sergioibarra98/Hot-Plate/HotPlate_TOP.png

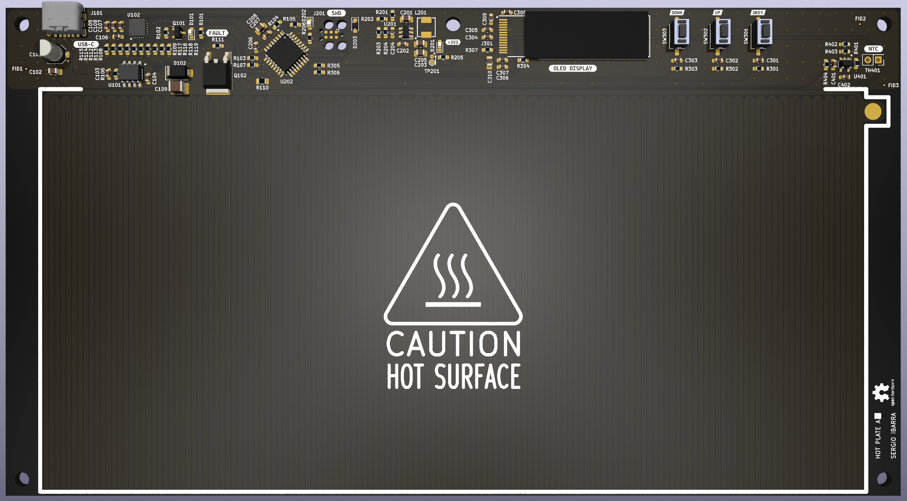
HotPlate_TOP.png
