sergioibarra98/Hot-Plate/01 - KiCad/report.txt

Plotted to 'C:\Users\sergi\Desktop\Hot-Plate\01 - Board\KiCad\HotPlate.pdf'.

Info: Done.
