sergioibarra98/Hot-Plate/03 - Studies/AP62200_AP62300_AP62400_Power-Calculation_Design.xlsx

Sheet: Power Loss
 |  |  |  |  |  |  |  |  |  | Note: In order for the design file to work
Version 2.1 |  |  |  |  |  |  |  |  |  |  | in local region.
 |  |  |  |  |  |  |  |  |  | 1. Go to File, then Option.
Power Loss Calculation |  |  |  |  |  |  |  |  |  | 2. Select Advance.
Part Munber | AP62300T |  |  |  |  |  |  |  |  | 3. Unselect Use System separator
Switching Frequency | 750 | kHz |  | On Time | 377.5225261 | ns
Input Voltage (4.2V-18V) | 12.0 | V |  | Duty Cycle | 0.28
Output Voltage (0.765V-7V) | 3.3 | V |  | Effective Output Resistance | 11.0 | Ohm
Output Current | 0.3 | A |  |  |  |  |  |  |  | 4. Change to local Decimal/Thousand separator to "." or ","
 |  |  |  | Iupper,rms | 0.17 | A |  |  |  | 5. Click OK.
OUTPUT INDUCTOR |  |  |  | Ilower,rms | 0.27 | A
Inductor Current Ripple Ratio (∆I/ILOAD) | 8 | %
Recommended Inductor | 10.3 | uH |  | Current Ripple | 0.32 | Ap-p
Output Inductor (Isat > 5A) | 10.0 | uH |  | Output Voltage Ripple | 12.22833333 | mVp-p |  | Conduction Loss | Switching Loss
DCR | 282 | mOhm |  |  |  |  | Upper MOSFET | 0.002 | 0.045
 |  |  |  |  |  |  | Lower MOSFET | 0.003 | 0.067
OUTPUT CAPACITOR |  |  |  |  |  |  | Driver |  | 0.002
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
