sergioibarra98/Hot-Plate/03 - Studies/01 - Power/Power Consumption.xlsx

Sheet: OVERVIEW
 |  | Corriente (A) | Potencia (W) |  | +15V | +3V3
+15V |  | 3.080 | 36.957 | Heater | Heater
 | +3V3 | 0.232 | 0.766 | PD | PD
 |  |  |  | MCU |  | MCU
 |  |  |  | OLED Screen |  | OLED Screen
 |  |  |  | Thermocoupler |  | Thermocoupler

Sheet: +15V
Descripción | Ref.Power | Consumo Max (mA) | Unidades | Consumo Total(A)
+3V3 |  |  |  | 0.080
Heater | - | 3000 | 1 | 3.000
PD | - | 85 | 1 | 0.085
 |  |  | TOTAL | 3.080

Sheet: +3V3
Descripción | Ref.Power | Consumo Max (mA) | Unidades | Consumo Total(A)
MCU |  | 200 | 1 | 0.200
OLED Screen | - | 30 | 1 | 0.030 |  | * No aparece en datahsset, estimado de otra pantalla de similar tamaño y mismo fab
Thermocoupler | - | 2 | 1 | 0.002
 |  |  | TOTAL | 0.232 | 0.7656 | w
 |  |  | TOTAL (+12V) | 0.080 | 0.957 | w
 |  |  |  |  | 0.1914 | W Ploss
MCU
IVDD |  | 120 | 1 | 120
I_IO |  | 80 | 1 | 80
 |  |  | total | 200

Sheet: MOSFET
 |  |  | NCE3080KA (https://www.lcsc.com/product-detail/MOSFETs_Wuxi-NCE-Power-Semiconductor-NCE3080KA_C152149.html)
I(RMS) | 3
R_DS(on) | 0.035
 |  | Pcon | 0.315
Vin | 12
fsw | 25000
Q_gs | 1.4e-08
Q_gd | 1.1e-08
I_g | 0.1
 |  | Ploss | 0.225
 |  | Ptot= | 0.54
