sergioibarra98/Hot-Plate/01 - KiCad/3D/CUI_DEVICES_TS04-66-50-BK-100-SMT.step

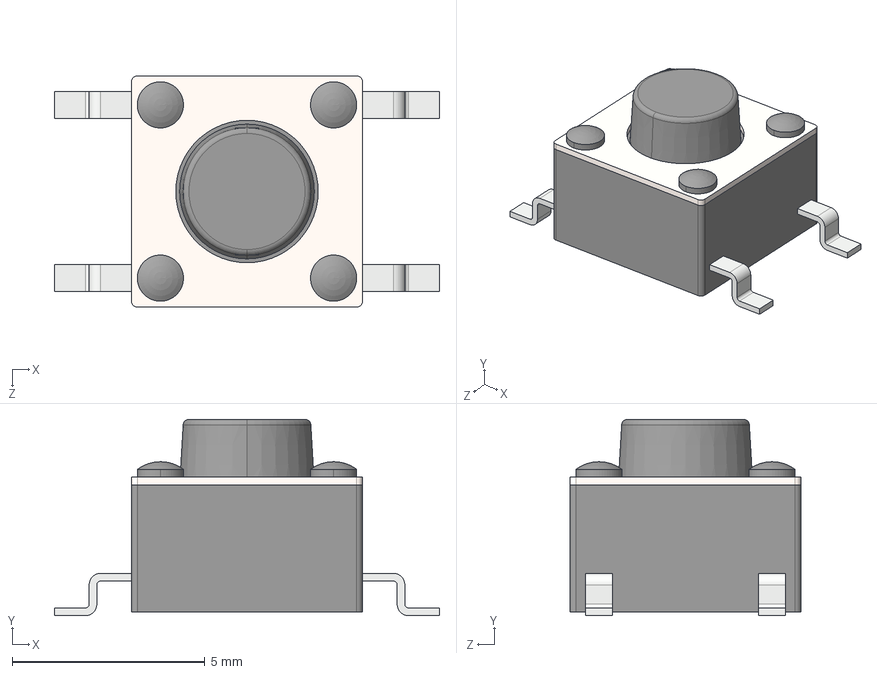
[picture p2: CAD file, 2023-08-11]
01 - KiCad/3D/CUI_DEVICES_TS04-66-50-BK-100-SMT.step
10.0 x 5.10 x 6.00 mm
