sergioibarra98/Hot-Plate/01 - KiCad/3D/SW_Push_1P1T_NO_3.5x8mm_H3mm.STEP

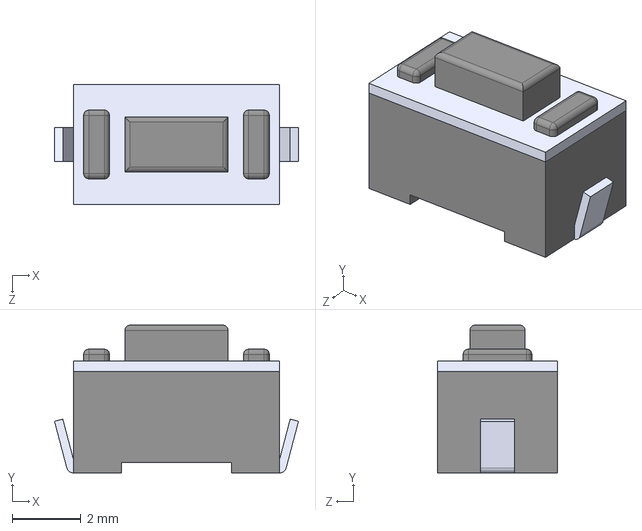
[picture p3: CAD file, 2023-08-11]
01 - KiCad/3D/SW_Push_1P1T_NO_3.5x8mm_H3mm.STEP
7.10 x 4.30 x 3.50 mm
