sergioibarra98/Hot-Plate/01 - KiCad/3D/0_91_inch_oled.step

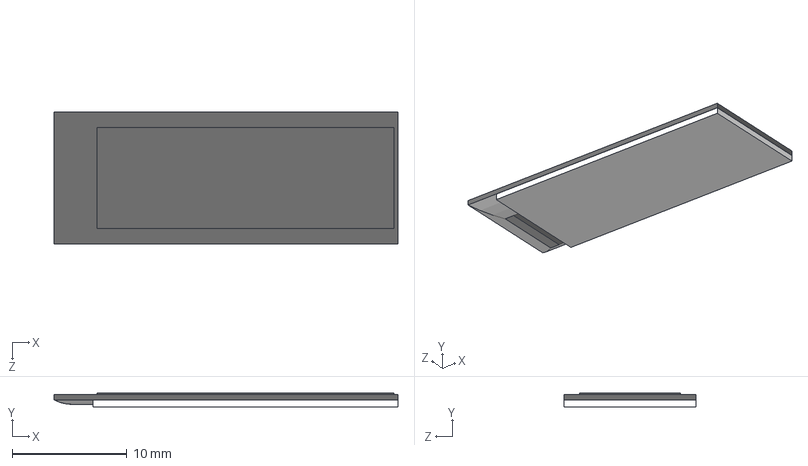
[picture p4: CAD file, 2023-08-11]
01 - KiCad/3D/0_91_inch_oled.step
30.0 x 1.20 x 11.5 mm
