sergioibarra98/Hot-Plate/01 - KiCad/3D/U262-061N-4BVC11.stp

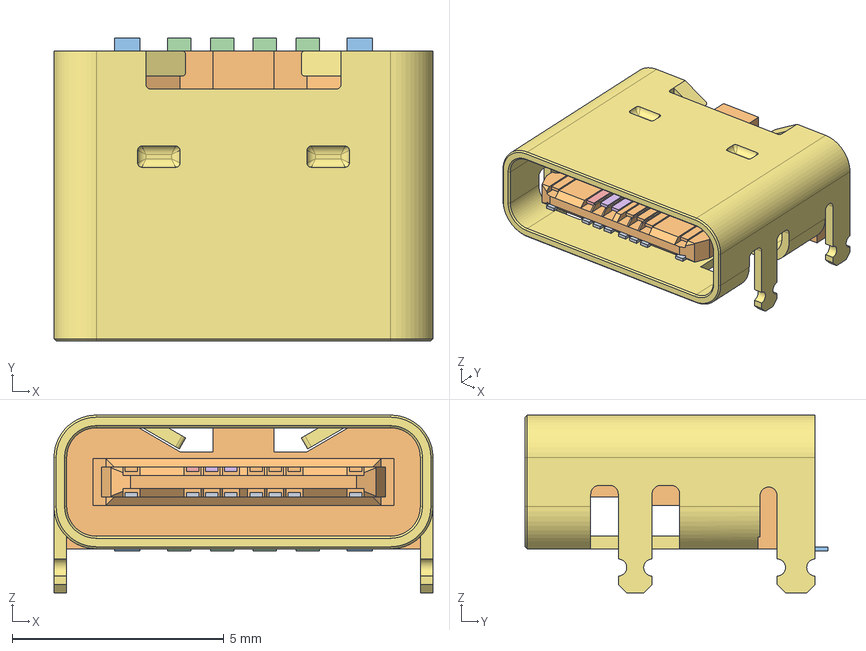
[picture p5: CAD file, 2023-05-15]
01 - KiCad/3D/U262-061N-4BVC11.stp
8.95 x 7.15 x 4.20 mm
