sergioibarra98/Hot-Plate/01 - KiCad/3D/IRF9358TRPBF.STEP

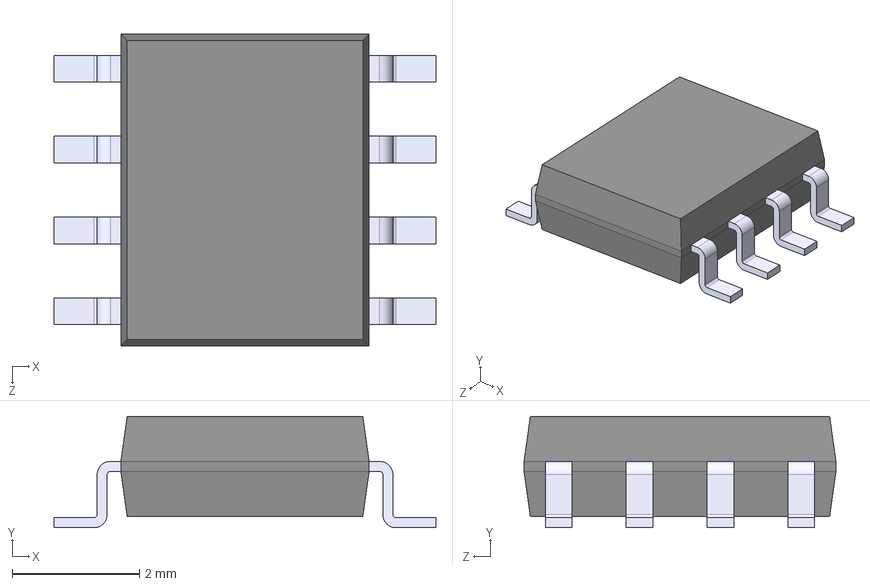
[picture p6: CAD file, 2023-05-15]
01 - KiCad/3D/IRF9358TRPBF.STEP
6.00 x 1.75 x 4.90 mm
