sergioibarra98/Hot-Plate/01 - KiCad/3D/CYPD3177-24LQXQT.stp

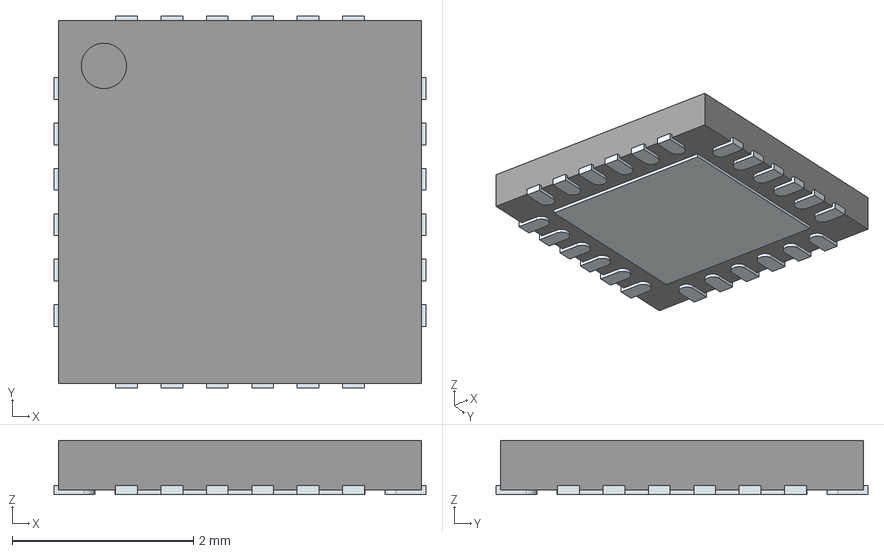
[picture p7: CAD file, 2023-05-15]
01 - KiCad/3D/CYPD3177-24LQXQT.stp
4.10 x 4.10 x 0.6 mm
ThermalPin
PinsArrayLR
PinsArrayTB
