sergioibarra98/Hot-Plate/00 - Outputs/Schematic.pdf

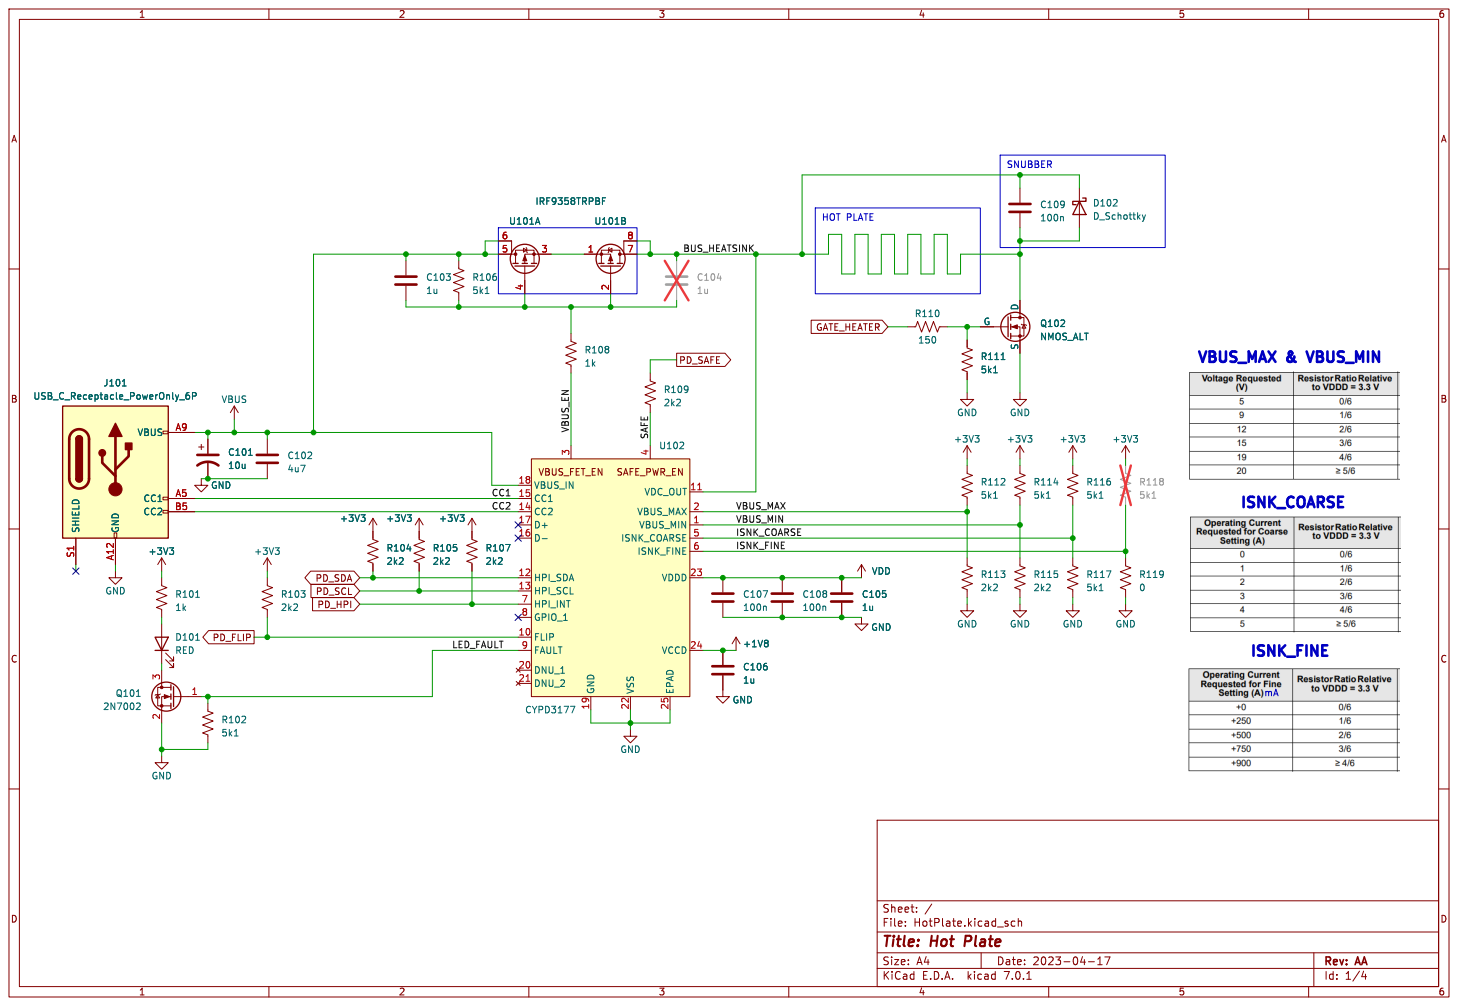
[picture p8: page 1]

Id: 1/4 Title: Hot Plate

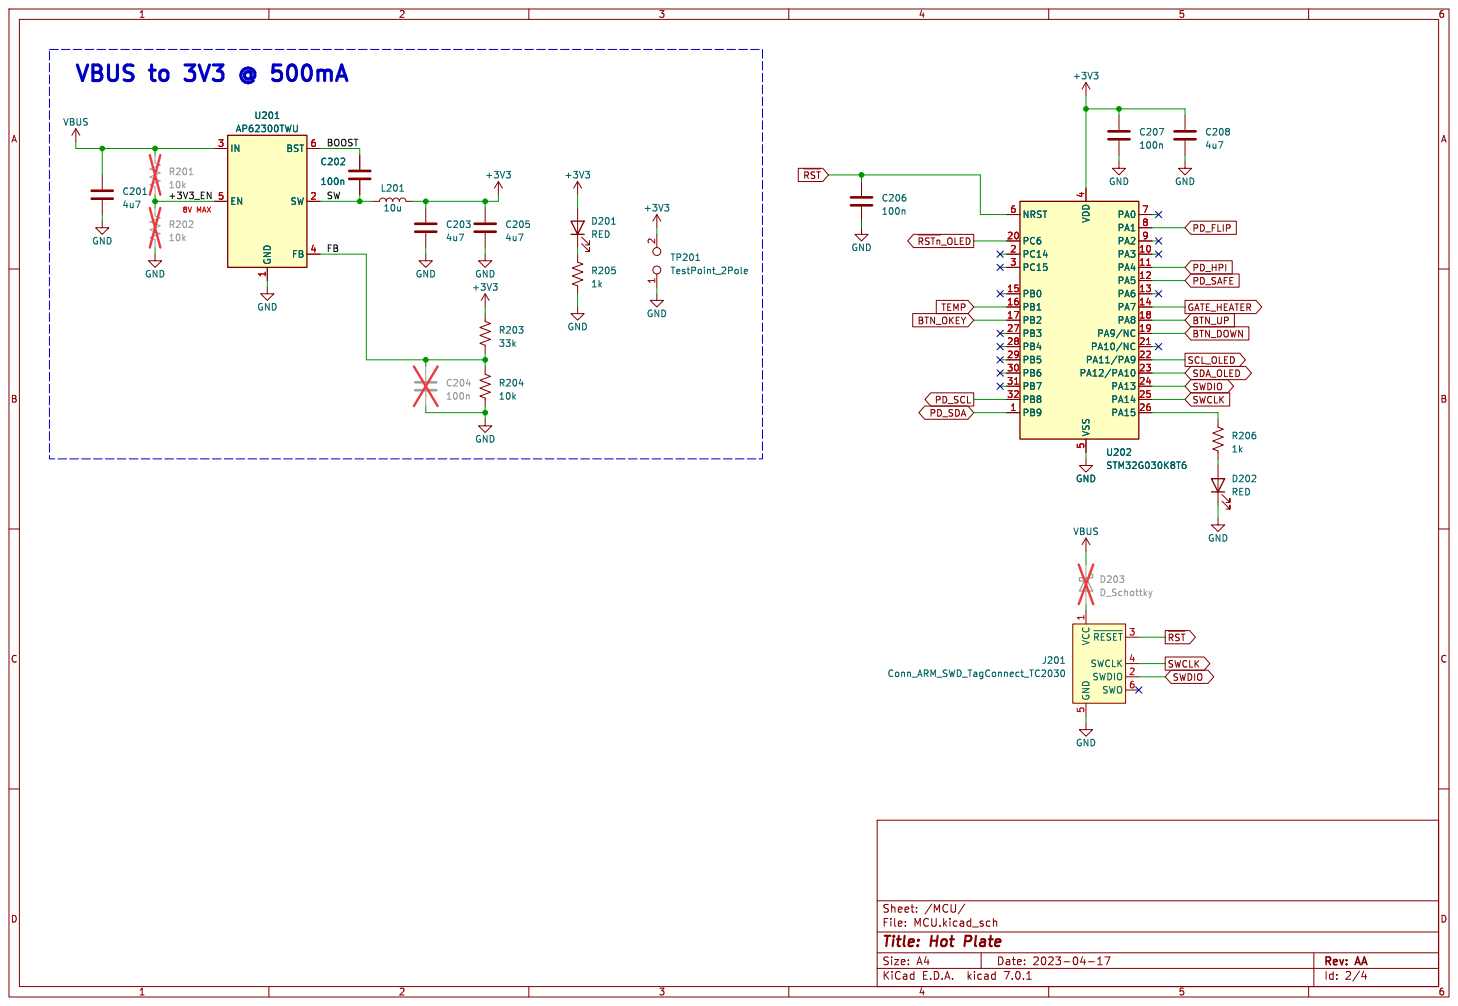
[picture p9: page 2]

1 SWDIO 2 ~{RESET}3 SWCLK 4 GND

Id: 2/4 Title: Hot Plate

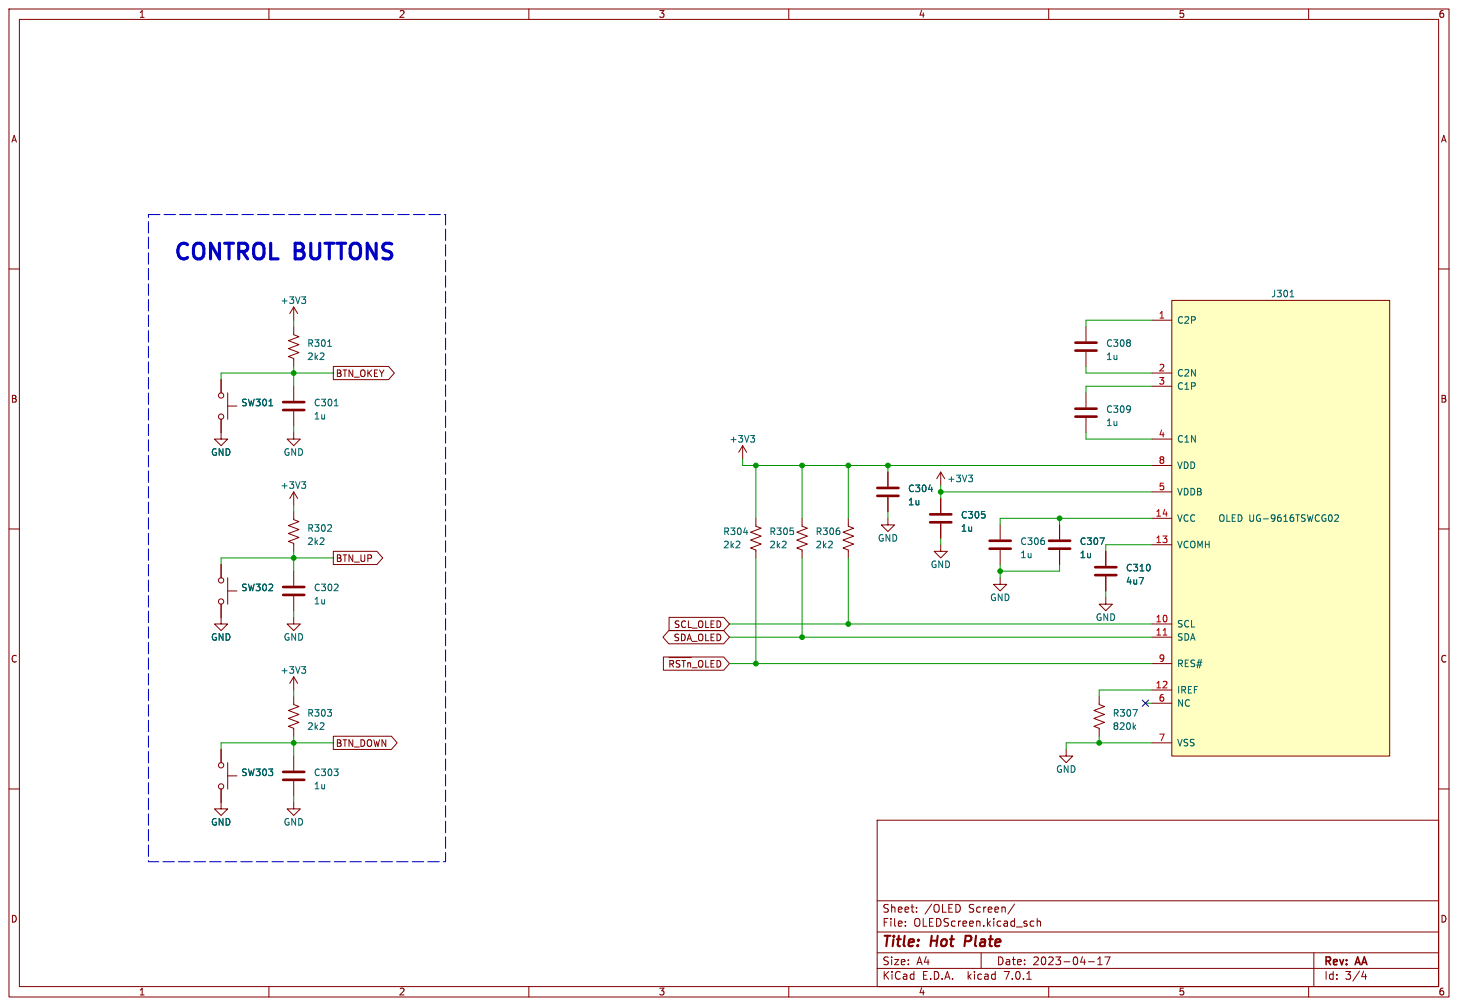
[picture p10: page 3]

Id: 3/4 Title: Hot Plate

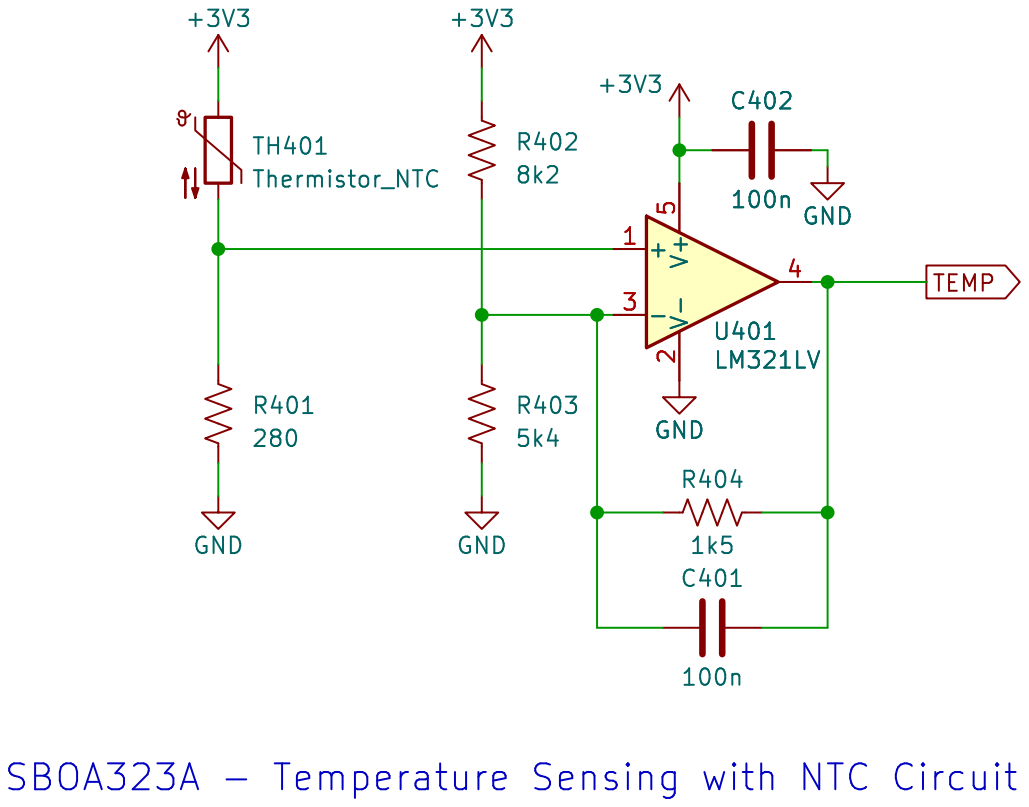
[picture p11: page 4]

File: thermocouple.kicad_sch Sheet: /Thermocouple/
Id: 4/4 Title: Hot Plate
