sergioibarra98/Hot-Plate/02 - Siumulation/04 - Mosfet/LTSpice.asc

C1: cap; 100n
C2: cap; 10µ
D1: schottky; RB058LAM-30
D2: diode; ID
D3: diode; ID
I1: current; {Isource}
I2: current; {Isink}
L1: ind; 10n
R1: res; 8
R2: res; 280
U1: Si3424CDV
V1: voltage; 12
V2: voltage; PULSE(0 3.3 10u 100n 100n 25u 50u)
Named nets: 0
.tran 100u
.param Isource 3
.param Isink=3
.model ID D(Ron=0 Roff=10Meg Vfwd=0)
Current limited voltage source
