sergioibarra98/Hot-Plate/02 - Siumulation/02 - BUS PMOS/PMOS.asc

C1: cap; 1µ
C2: cap; 1µ
M1: pmos; SQ4949EY_Q1
M2: pmos; SQ4949EY_Q1
R1: res; 1k
R2: res; 5k1
S1: sw; MYSW
V1: voltage; PULSE(0 12 500m 100m 0 100)
V2: voltage; PULSE(0 3 2 1m 1m 10)
Named nets: 0, VOUT_1, VIN
DNP
Not working without output capacitance
.model MYSW SW(Ron=1 Roff=1Meg Vt=.5 Vh=-.4)
.tran 5
