sergioibarra98/Hot-Plate/02 - Siumulation/01 - LED Fault/LED_FAULT.asc

D1: diode; LED_RED
R1: res; 400
U1: 2N7002NXAK
V1: voltage; PULSE(0 3.3 50m 100n 100n 1)
V2: voltage; 3.3
Named nets: 0
.MODEL LED_RED D (IS=93.1P RS=42M N=4.61 BV=4 IBV=10U
+ CJO=2.97P VJ=.75 M=.333 TT=4.32U)
.tran 100m
