sergioibarra98/Hot-Plate/02 - Siumulation/03 - Push Button/LTSpice.asc

C1: cap; 1µ
C2: cap; 1µ
R1: res; 2K4
R2: res; 2k4
S1: sw; MYSW
S2: sw; MYSW
V1: voltage; 3.3
V2: voltage; PULSE(0 1 30m 100n 100n 50u 100u 10)
V3: voltage; 3.3
V4: voltage; PULSE(0 1 31m 100n 100n 30m 0 1)
V5: voltage; PULSE(0 1 30m 100n 100n 50u 100u 10)
V6: voltage; PULSE(0 1 31m 100n 100n 30m 0 1)
Named nets: 0, PULL_UP, PULL_DOWN
.tran 100m
.model MYSW SW(Ron=1 Roff=1Meg Vt=.5 Vh=-.4)
