sergioibarra98/Hot-Plate/01 - KiCad/HotPlate.kicad_pcb

## KiCad design 01 - KiCad/HotPlate.kicad_pcb (2024-01-25)

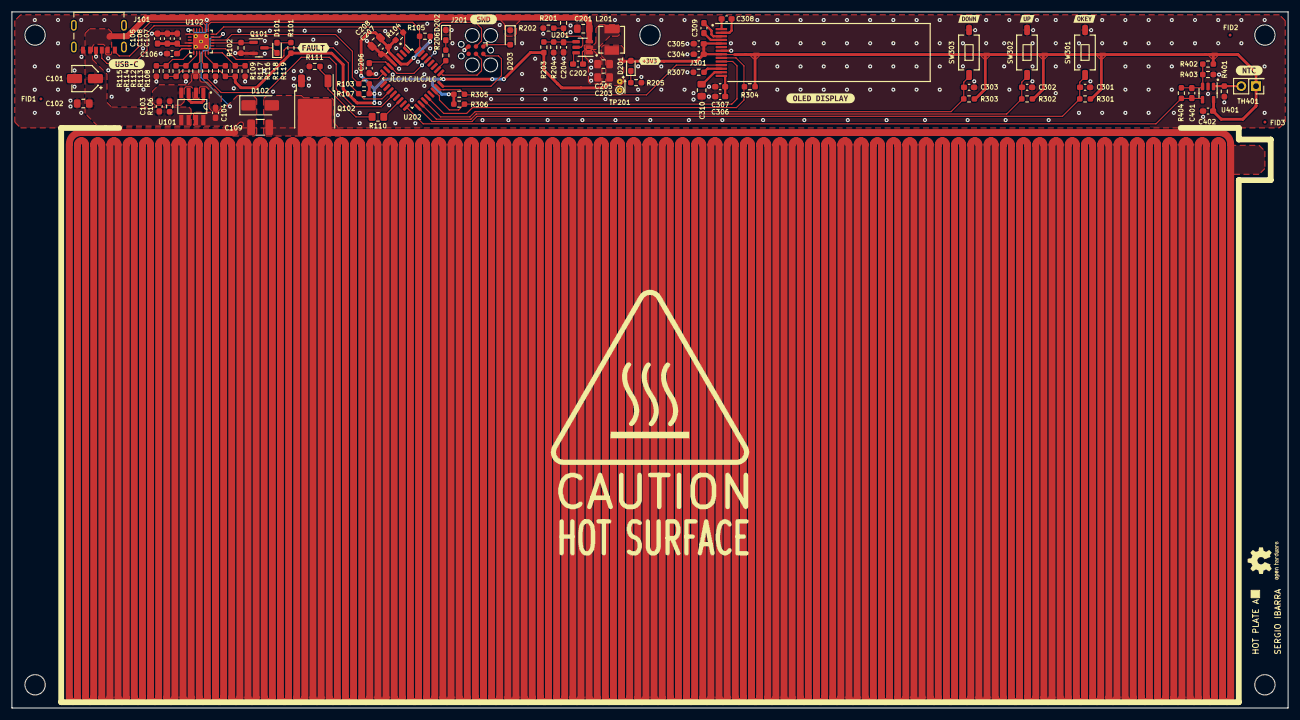
[picture p12: board HotPlate.kicad_pcb from above]

Board: 2 copper layers, 220.0 x 120.0 mm, 96 parts (0 on the bottom side), 53 nets.

Parts:
C101: 10u; CP_Elec_4x5.4
C102, C201, C203, C205, C208, C310: 4u7; C_0805_2012Metric_Pad1.18x1.45mm_HandSolder
C103, C104, C105, C106, C301, C302, C303, C304, C305, C306, C307, C308, C309: 1u; C_0603_1608Metric_Pad1.08x0.95mm_HandSolder
C107, C108, C202, C204, C206, C207, C401, C402: 100n; C_0603_1608Metric_Pad1.08x0.95mm_HandSolder
C109: 100n; C_1210_3225Metric_Pad1.33x2.70mm_HandSolder
D101, D201, D202: RED; LED_0603_1608Metric_Pad1.05x0.95mm_HandSolder
D102: D_Schottky; D_SMA
D203: D_Schottky; D_SOD-323_HandSoldering
FID1: Fiducial_0.5mm_Mask1mm
J101: USB_C_Receptacle_PowerOnly_6P; U262-061N-4BVC11
J201: Conn_ARM_SWD_TagConnect_TC2030; Tag-Connect_TC2030-IDC-FP_2x03_P1.27mm_Vertical
J301: OLED UG-9616TSWCG02; UG-9616TSWCG02
L201: 10u; L_4.2x4.4_H2
Q101: 2N7002; SOT-23
Q102: NMOS_ALT; TO-252-2
R101, R108, R205, R206: 1k; R_0603_1608Metric_Pad0.98x0.95mm_HandSolder
R102, R106, R111, R112, R114, R116, R117, R118: 5k1; R_0603_1608Metric_Pad0.98x0.95mm_HandSolder
R103, R104, R105, R107, R109, R113, R115, R301, R302, R303, R304, R305, R306: 2k2; R_0603_1608Metric_Pad0.98x0.95mm_HandSolder
R110: 150; R_0805_2012Metric_Pad1.20x1.40mm_HandSolder
R119: 0; R_0603_1608Metric_Pad0.98x0.95mm_HandSolder
R201, R202, R204: 10k; R_0603_1608Metric_Pad0.98x0.95mm_HandSolder
R203: 33k; R_0603_1608Metric_Pad0.98x0.95mm_HandSolder
R307: 820k; R_0603_1608Metric_Pad0.98x0.95mm_HandSolder
R401: 280; R_0603_1608Metric_Pad0.98x0.95mm_HandSolder
R402: 8k2; R_0603_1608Metric_Pad0.98x0.95mm_HandSolder
R403: 5k4; R_0603_1608Metric_Pad0.98x0.95mm_HandSolder
R404: 1k5; R_0603_1608Metric_Pad0.98x0.95mm_HandSolder
SW301, SW302, SW303: SW_Push; SW_Push_1P1T_NO_3.5x8mm_H3mm
TH401: Thermistor_NTC; PinHeader_2x01_P2.54mm_Vertical
TP201: TestPoint_2Pole; TestPoint_Pad_D1.0mm_DUAL
U101: IRF9358TRPBF; SOIC-8
U102: CYPD3177; PG-VQFN-24
U201: AP62300TWU; TSOT-23-6
U202: STM32G030K8T6; LQFP-32_7x7mm_P0.8mm
U401: LM321LV; SOT-23-5
kibuzzard-64D5DEAF: G***; kibuzzard-64D5DEAF
kibuzzard-64D5E8FE: G***; kibuzzard-64D5E8FE
kibuzzard-64D73B55: G***; kibuzzard-64D73B55
kibuzzard-64D73B79: G***; kibuzzard-64D73B79
kibuzzard-64D73B89: G***; kibuzzard-64D73B89
kibuzzard-64D73C73: G***; kibuzzard-64D73C73
kibuzzard-64D50818: G***; kibuzzard-64D50818
kibuzzard-64D50885: G***; kibuzzard-64D50885
kibuzzard-64D63906: G***; kibuzzard-64D63906

Connections:
+1V8: C106.1, U102.24 (VCCD)
+3V3: C203.1, C205.1, C207.1, C208.1, C304.1, C305.1, C402.2, D201.2 (A), J301.5 (VDDB), J301.8 (VDD), L201.2, R101.1, R103.1, R104.1, R105.1, R107.1, R112.1, R114.1, R116.1, R118.1, R203.1, R301.1, R302.1, R303.1, R304.1, R305.1, R306.1, R402.1, TH401.1, TP201.2, U202.4 (VDD), U401.5 (V+)
/BUS_HEATSINK: C104.1, C109.1, C109.2, D102.1 (K), D102.2 (A), Q102.2 (D), U101.7 (D2), U101.8 (D2), U102.11 (VDC_OUT)
/CC1: J101.A5 (CC1), U102.15 (CC1)
/CC2: J101.B5 (CC2), U102.14 (CC2)
/ISNK_COARSE: R116.2, R117.1, U102.5 (ISNK_COARSE)
/ISNK_FINE: R118.2, R119.1, U102.6 (ISNK_FINE)
/LED_FAULT: Q101.1 (G), R102.1, U102.9 (FAULT)
/MCU/+3V3_EN: R201.2, R202.1, U201.5 (EN)
/MCU/BOOST: C202.1, U201.6 (BST)
/MCU/FB: C204.1, R203.2, R204.1, U201.4 (FB)
/MCU/SW: C202.2, L201.1, U201.2 (SW)
/SAFE: R109.2, U102.4
/VBUS_EN: R108.2, U102.3
/VBUS_MAX: R112.2, R113.1, U102.2 (VBUS_MAX)
/VBUS_MIN: R114.2, R115.1, U102.1 (VBUS_MIN)
BTN_DOWN: C303.1, R303.2, SW303.1, U202.19 (PA9/NC)
BTN_OKEY: C301.1, R301.2, SW301.1, U202.17 (PB2)
BTN_UP: C302.1, R302.2, SW302.1, U202.18 (PA8)
GATE_HEATER: R110.1, U202.14 (PA7)
GND: C101.2, C102.2, C105.2, C106.2, C107.2, C108.2, C201.2, C203.2, C204.2, C205.2, C206.2, C207.2, C208.2, C301.2, C302.2, C303.2, C304.2, C305.2, C306.2, C307.2, C310.2, C402.1, D202.1 (K), J101.A12 (GND), J101.B12 (GND), J201.5 (GND), J301.7 (VSS), Q101.2 (S), Q102.3 (S), R102.2, R111.2, R113.2, R115.2, R117.2, R119.2, R202.2, R204.2, R205.2, R307.2, R401.2, R403.2, SW301.2, SW302.2, SW303.2, TP201.1, U102.19 (GND), U102.22 (VSS), U102.25 (EPAD), U201.1 (GND), U202.5 (VSS), U401.2 (V-)
unnamed: D101.2 (A), R101.2
unnamed: D101.1 (K), Q101.3 (D)
unnamed: D201.1 (K), R205.1
unnamed: D202.2 (A), R206.2
unnamed: D203.2 (A), J201.1 (VCC)
unnamed: C309.2, J301.4 (C1N)
unnamed: C309.1, J301.3 (C1P)
unnamed: C308.2, J301.2 (C2N)
unnamed: C308.1, J301.1 (C2P)
unnamed: J301.12 (IREF), R307.1
unnamed: C306.1, C307.1, J301.14 (VCC)
unnamed: C310.1, J301.13 (VCOMH)
unnamed: Q102.1 (G), R110.2, R111.1
unnamed: C103.2, C104.2, R106.2, R108.1, U101.2 (G2), U101.4 (G1)
unnamed: U101.1 (S2), U101.3 (S1)
unnamed: R206.1, U202.26 (PA15)
unnamed: R401.1, TH401.2, U401.1 (+)
unnamed: C401.2, R402.2, R403.1, R404.1, U401.3 (-)
PD_FLIP: R103.2, U102.10 (FLIP), U202.8 (PA1)
PD_HPI: R107.2, U102.7 (HPI_INT), U202.11 (PA4)
PD_SAFE: R109.1, U202.12 (PA5)
PD_SCL: R105.2, U102.13 (HPI_SCL), U202.32 (PB8)
PD_SDA: R104.2, U102.12 (HPI_SDA), U202.1 (PB9)
SCL_OLED: J301.10 (SCL), R306.2, U202.22 (PA11/PA9)
SDA_OLED: J301.11 (SDA), R305.2, U202.23 (PA12/PA10)
SWCLK: J201.4 (SWCLK), U202.25 (PA14)
SWDIO: J201.2 (SWDIO), U202.24 (PA13)
TEMP: C401.1, R404.2, U202.16 (PB1), U401.4
VBUS: C101.1, C102.1, C103.1, C201.1, D203.1 (K), J101.A9 (VBUS), J101.B9 (VBUS), R106.1, R201.1, U101.5 (D1), U101.6 (D1), U102.18 (VBUS_IN), U201.3 (IN)
VDD: C105.1, C107.1, C108.1, U102.23 (VDDD)
~RSTn_OLED: J301.9 (RES#), R304.2, U202.20 (PC6)
~RST: C206.1, J201.3 (~RESET), U202.6 (NRST)
