sergioibarra98/Hot-Plate/04 - Software/HOT_PLATE/Core/Src/main.c

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
/* Includes ------------------------------------------------------------------*/
#include "main.h"

/* USER CODE BEGIN Includes */
#include "stdio.h"
#include "ssd1306.h"
#include "ssd1306_fonts.h"
#include "FIRFilter.h"
#include "PI.h"
/* USER CODE END Includes */

/* USER CODE BEGIN PTD */
// Enumeration for screen colors
typedef enum {
    BTN_OK,
    BTN_UP,
	BTN_DOWN,
	BTN_NONE
} BTN_STATUS;
/* USER CODE END PTD */

ADC_HandleTypeDef hadc1;

I2C_HandleTypeDef hi2c1;
I2C_HandleTypeDef hi2c2;

TIM_HandleTypeDef htim1;
TIM_HandleTypeDef htim3;

/* USER CODE BEGIN PV */
const int16_t I2C_PD_ADDRESS = (0x08 << 1);
const int16_t I2C_PD_REG_VBUS = 0x0D10;

FIRFilter fir;
PIDREG3 PI_temp;
int16_t state = 0;
BTN_STATUS btn = BTN_NONE;
int16_t voltage;
uint8_t tempVoltage[2];
int16_t duty;
int16_t temp;
char string[9];
int16_t adc_buf[10];
int16_t ref_Temp = 50;
/* USER CODE END PV */

void SystemClock_Config(void);
static void MX_GPIO_Init(void);
static void MX_I2C1_Init(void);
static void MX_I2C2_Init(void);
static void MX_ADC1_Init(void);
static void MX_TIM3_Init(void);
static void MX_TIM1_Init(void);
/* USER CODE BEGIN PFP */
static void ssd1306_WriteScreen(char* str, FontDef Font);
void HAL_GPIO_EXTI_Falling_Callback(uint16_t GPIO_Pin);
void HAL_ADC_ConvCpltCallback(ADC_HandleTypeDef *hadc);
/* USER CODE END PFP */

/**
  * @brief  The application entry point.
  * @retval int
  */
int main(void)
{
  /* MCU Configuration--------------------------------------------------------*/

  /* Reset of all peripherals, Initializes the Flash interface and the Systick. */
  HAL_Init();

  /* Configure the system clock */
  SystemClock_Config();

  /* Initialize all configured peripherals */
  MX_GPIO_Init();
  MX_I2C1_Init();
  MX_I2C2_Init();
  MX_ADC1_Init();
  MX_TIM3_Init();
  MX_TIM1_Init();
  /* USER CODE BEGIN 2 */
  //INITS
  ssd1306_Init();
  FIRFilter_Init(&fir);
  PID_Init(&PI_temp);

  //ACD calibration and trigger
  while(HAL_ADCEx_Calibration_Start(&hadc1) != HAL_OK);
  HAL_ADC_Start_IT(&hadc1);
  HAL_TIM_PWM_Start(&htim1, TIM_CHANNEL_2);

  /* USER CODE END 2 */

  /* Infinite loop */
  /* USER CODE BEGIN WHILE */
  while (1)
  {
	  //GUI
	  switch(state){
	  case 0:
		  ssd1306_WriteScreen(" HEATER ", Font_11x18);
		  break;
	  case 1:
		  ssd1306_WriteScreen("START", Font_11x18);
		  HAL_TIM_PWM_Stop(&htim3, TIM_CHANNEL_2);
		  break;
	  case 11:
		  //Start PWM
		  TIM3->CCR2 = (TIM_CCR2_CCR2 & (duty - 1));
		  HAL_TIM_PWM_Start(&htim3, TIM_CHANNEL_2);
		  //Refresh Screen
		  sprintf(string, "%5d~C", temp);
		  ssd1306_WriteScreen(string, Font_11x18);

		  break;
	  case 2:
		  ssd1306_WriteScreen("CONFIG", Font_11x18);
		  break;
	  case 21:
		  sprintf(string, "%5d~C", ref_Temp);
		  ssd1306_WriteScreen(string, Font_11x18);
		  break;
	  case 3:
		  ssd1306_WriteScreen("VIEW", Font_11x18);
		  break;
	  case 31:
		  HAL_I2C_Mem_Read(&hi2c1, I2C_PD_ADDRESS, I2C_PD_REG_VBUS, 2, tempVoltage, 2, HAL_MAX_DELAY);
		  voltage = ((tempVoltage[1]<<8)+tempVoltage[0]) * (float)0.1;

		  sprintf(string, "%dV", voltage);
		  ssd1306_WriteScreen(string, Font_11x18);
		  break;
	  default:
		  break;
	  }

	  //NEXT STATE
	  if(btn != BTN_NONE){
		  switch (state){
		  case 0:
			  state = 1;
			  break;
		  case 1:
			  if(btn == BTN_OK){
				  state = 11;
			  } else if (btn == BTN_UP){
				  state = 2;
			  } else if (btn == BTN_DOWN){
				  state = 3;
			  } else {
				  state = 0;
			  }
			  break;
		  case 2:
			  if(btn == BTN_OK){
				  state = 21;
			  } else if (btn == BTN_UP){
				  state = 3;
			  } else if (btn == BTN_DOWN){
				  state = 1;
			  } else {
				  state = 0;
			  }
			  break;
		  case 21:
			  if(btn == BTN_OK){
				  state = 2;
			  } else if (btn == BTN_UP){
				  ref_Temp++;
			  } else if (btn == BTN_DOWN){
				  ref_Temp--;
			  } else {
				  state = 0;
			  }
			  break;
		  case 3:
			  if(btn == BTN_OK){
				  state = 31;
			  } else if (btn == BTN_UP){
				  state = 1;
			  } else if (btn == BTN_DOWN){
				  state = 2;
			  } else {
				  state = 0;
			  }
			  break;
		  case 31:
			  if(btn == BTN_OK){
				  state = 3;
			  } else if (btn == BTN_UP){
				  state = 3;
			  } else if (btn == BTN_DOWN){
				  state = 3;
			  } else {
				  state = 0;
			  }
			  break;
		  default:
			  state = 0;
			  break;
		  }

		  btn = BTN_NONE;
	  }

    /* USER CODE END WHILE */

    /* USER CODE BEGIN 3 */
  }
  /* USER CODE END 3 */
}

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
/* USER CODE BEGIN 4 */
static void ssd1306_WriteScreen(char* str, FontDef Font){
	  ssd1306_Fill(Black);
	  ssd1306_SetCursor(32, 0);
	  ssd1306_WriteString(str, Font, White);
	  ssd1306_UpdateScreen();
}

void HAL_GPIO_EXTI_Falling_Callback(uint16_t GPIO_Pin) {
	if(GPIO_Pin == GPIO_BTN_OK_Pin) {
		btn = BTN_OK;
	} else if (GPIO_Pin == GPIO_BTN_UP_Pin){
		btn = BTN_UP;
	} else if (GPIO_Pin == GPIO_BTN_DOWN_Pin) {
		btn = BTN_DOWN;
	}
}

void HAL_ADC_ConvCpltCallback(ADC_HandleTypeDef *hadc){
	HAL_GPIO_WritePin(GPIO_TEST_GPIO_Port, GPIO_TEST_Pin, GPIO_PIN_SET);
	int16_t adcValue = HAL_ADC_GetValue(hadc);
	temp = FIRFilter_Update(&fir, adcValue);

	PI_temp.Ref = ref_Temp;
	PI_temp.Fdb = temp;
//	PID_MACRO (PI_temp);
	duty = PID_Update(&PI_temp);
	HAL_GPIO_WritePin(GPIO_TEST_GPIO_Port, GPIO_TEST_Pin, GPIO_PIN_RESET);
}

/* USER CODE END 4 */

/**
  * @brief  Period elapsed callback in non blocking mode
  * @note   This function is called  when TIM17 interrupt took place, inside
  * HAL_TIM_IRQHandler(). It makes a direct call to HAL_IncTick() to increment
  * a global variable "uwTick" used as application time base.
  * @param  htim : TIM handle
  * @retval None
  */
void HAL_TIM_PeriodElapsedCallback(TIM_HandleTypeDef *htim)
{
  if (htim->Instance == TIM17) {
    HAL_IncTick();
  }
}

/**
  * @brief  This function is executed in case of error occurrence.
  * @retval None
  */
void Error_Handler(void)
{
  /* USER CODE BEGIN Error_Handler_Debug */
  /* User can add his own implementation to report the HAL error return state */
  __disable_irq();
  while (1)
  {
  }
  /* USER CODE END Error_Handler_Debug */
}

#ifdef  USE_FULL_ASSERT
/**
  * @brief  Reports the name of the source file and the source line number
  *         where the assert_param error has occurred.
  * @param  file: pointer to the source file name
  * @param  line: assert_param error line source number
  * @retval None
  */
void assert_failed(uint8_t *file, uint32_t line)
{
  /* USER CODE BEGIN 6 */
  /* User can add his own implementation to report the file name and line number,
     ex: printf("Wrong parameters value: file %s on line %d\r\n", file, line) */
  /* USER CODE END 6 */
}
#endif /* USE_FULL_ASSERT */
