sergioibarra98/Hot-Plate/04 - Software/HOT_PLATE/HOT_PLATE.ioc

Mcu.UserName=STM32G030K8Tx
PA13.Signal=SYS_SWDIO
PA14-BOOT0.Signal=SYS_SWCLK
PA15.GPIO_Label=GPIO_LED
PA15.Signal=GPIO_Output
PA2.GPIO_Label=GPIO_TEST
PA2.Signal=GPIO_Output
PA7.GPIO_Label=GATE_PWM
PA7.Signal=S_TIM3_CH2
PA8.GPIO_Label=GPIO_BTN_UP
PA8.Signal=GPXTI8
PA9.GPIO_Label=GPIO_BTN_DOWN
PA9.Signal=GPXTI9
PB1.GPIO_Label=ADC_NTC
PB1.Signal=ADC1_IN9
PB2.GPIO_Label=GPIO_BTN_OK
PB2.Signal=GPXTI2
PB8.GPIO_Label=I2C_PD_SCL
PB8.Signal=I2C1_SCL
PB9.GPIO_Label=I2C_PD_SDA
PB9.Signal=I2C1_SDA
