sergioibarra98/Hot-Plate/04 - Software/HOT_PLATE/Core/Inc/main.h

#define I2C_PD_SDA_Pin GPIO_PIN_9
#define I2C_PD_SDA_GPIO_Port GPIOB
#define GPIO_TEST_Pin GPIO_PIN_2
#define GPIO_TEST_GPIO_Port GPIOA
#define GATE_PWM_Pin GPIO_PIN_7
#define GATE_PWM_GPIO_Port GPIOA
#define ADC_NTC_Pin GPIO_PIN_1
#define ADC_NTC_GPIO_Port GPIOB
#define GPIO_BTN_OK_Pin GPIO_PIN_2
#define GPIO_BTN_OK_GPIO_Port GPIOB
#define GPIO_BTN_OK_EXTI_IRQn EXTI2_3_IRQn
#define GPIO_BTN_UP_Pin GPIO_PIN_8
#define GPIO_BTN_UP_GPIO_Port GPIOA
#define GPIO_BTN_UP_EXTI_IRQn EXTI4_15_IRQn
#define GPIO_BTN_DOWN_Pin GPIO_PIN_9
#define GPIO_BTN_DOWN_GPIO_Port GPIOA
#define GPIO_BTN_DOWN_EXTI_IRQn EXTI4_15_IRQn
#define I2C_OLED_SCL_Pin GPIO_PIN_11
#define I2C_OLED_SCL_GPIO_Port GPIOA
#define I2C_OLED_SDA_Pin GPIO_PIN_12
#define I2C_OLED_SDA_GPIO_Port GPIOA
#define GPIO_LED_Pin GPIO_PIN_15
#define GPIO_LED_GPIO_Port GPIOA
#define I2C_PD_SCL_Pin GPIO_PIN_8
#define I2C_PD_SCL_GPIO_Port GPIOB
