sergioibarra98/Hot-Plate/(commit log)

2023-04-08 Temperature Simulation
    [TempSimulation - simplified.xlsx, TempSimulation.xlsx]
2023-05-15 OLED Display schematic
    [CYPD3177-24LQXQT.stp, HotPlate.kicad_pcb, HotPlate.kicad_sch, IRF9358TRPBF.STEP, MCU.kicad_sch, U262-061N-4BVC11.stp, screen.kicad_sch]
2023-05-15 Added simulations
    [TempSimulation - simplified.xlsx, TempSimulation.xlsx]
2023-08-11 PCB order
    [0_91_inch_oled.step, AP62200_AP62300_AP62400_Power-Calculation_Design.xlsx, CUI_DEVICES_TS04-66-50-BK-100-SMT.step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]
2023-08-11 Added 3D board
2023-11-12 Reorder files
    [0_91_inch_oled.step, CUI_DEVICES_TS04-66-50-BK-100-SMT.step, CYPD3177-24LQXQT.stp, HotPlate.kicad_pcb, HotPlate.kicad_sch, IRF9358TRPBF.STEP, MCU.kicad_sch, OLEDScreen.kicad_sch]
2024-01-23 PI implemented
    [TempSimulation_15.xlsx]
2024-01-25 SW 0.1 & updated Schematic
    [HotPlate.kicad_pcb, MCU.kicad_sch, OLEDScreen.kicad_sch]
