sergioibarra98/Hot-Plate/(notices)

Notices in the files:
04 - Software/HOT_PLATE/Core/Src/main.c:
Copyright (c) 2024 STMicroelectronics.
All rights reserved.
This software is licensed under terms that can be found in the LICENSE file
